hoelzlem/SchBat/README.md

# SchBat
Schaltungsentwicklung für Batteriesysteme Praktikum
