hoelzlem/SchBat/Poster/Ladezustandsbestimmung.pptx

## Ladezustandsbestimmung

Technische Universität München
Fakultät für Elektrotechnik
Lehrstuhl für Elektrische Energiespeichertechnik
Simon Diehl
Markus Hölzle
März 2018

- mit Ruhespannungskennline und Ladungsmessung

- Implementierung von Hard- und Software

- Ziel: Bestimmung der aktuell im Akku enthaltenen Ladung und der verbleibenden Laufzeit des Systems beziehungsweise der Restladezeit
- Motivation: Mit dieser Information, kann der Nutzer besser bewerten, ob die aktuelle Betriebsdauer der Leuchte für den angedachten Einsatz noch ausreicht. Unvorhergesehener Ausfall ist, ein Defekt ausgenommen, kaum noch möglich.

Ziel

1. Bestimmung des initialen Ladezustands beim Start des Geräts mittels der Klemmenspannung aus der vorher bekannten Ruhespannungskennlinie
2. Messung der geflossenen Ladung (Laden oder Entladen), um den Ladezustand während des Betriebs zu beobachten. Bedingt durch den Stromfluss im Betrieb und die damit einhergehenden Überspannungen im Akku ist eine Bestimmung mittels Ruhespannungskennlinie hier nicht mehr möglich.

Prinzip

Spannungsmessung

- Bestimmung des initialen Ladezustand aus Messung der Klemmenspannung der verbundenen Zelle
- Nach ausreichend langer Ruhezeit kann angenommen werden, dass die Klemmenspannung der Gleichgewichtsspannung der Zelle entspricht und die Abbildung f:U_K →SOC somit gültig ist
- Differenzielle Messung über unbelastete Anschlüsse → Laststrombedingte Spannungsfälle werden vermieden
- Abschaltung der Messelektronik für geringen Ruhestrom → Schutz vor Tiefentladung
- Die unjustierte Genauigkeit beträgt etwa 10 mV und führt damit zu einem maximalen Fehler von circa 5 % SOC

Signalverarbeitung

Strommessung

- Für die Aktualisierung des Ladezustands im Betrieb wird die geflossene Ladung herangezogen. Diese kann durch Integration des Laststroms über die Zeit berechnet werden.
- Ermittlung des Klemmenstroms mittels Messwiderstand → hohe Genauigkeit und Bandbreite bei niedrigen Kosten
- Messung auf Seite der positiven Versorgungsspannung → Beeinflussung des Bezugspotenzials wird verhindert
- Zeitdiskrete Integration benötigt eine genaue Zeitbasis → Minimierung von Driftfehlern → Generierung mit Quarzoszillator mit einer Genauigkeit von 30 ppm
- Die unjustierte Genauigkeit beträgt im Versuch etwa 10 mA und führt damit zu einem Fehler von 10mA⋅t/C_N was im gegebenen Fall circa 0.5% SOC pro Betriebsstunde entspricht

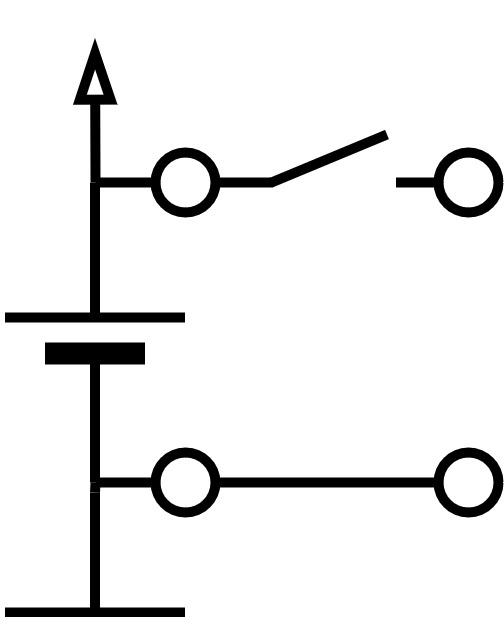
[picture p4: figure]
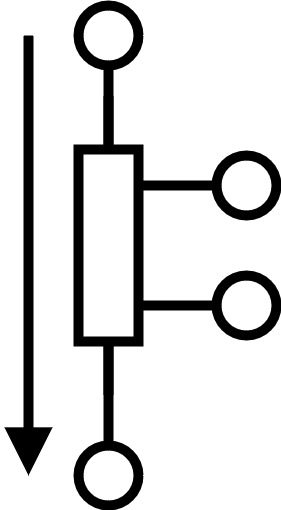
[picture p5: figure]

Die Sensorik für Spannungs- und Strommessung benötigt analoge sowie digitale Signalverarbeitung, um nutzbare Messdaten liefern zu können. Die Messkette ist dabei für beide gleich.

Differenzverstärker
- Messsignal auf FSR des ADC anpassen
- Gleichtaktsignal unterdrücken, um Informationsgehalt zu maximieren
- Hohe Bandbreite: f_g ≥10 kHz

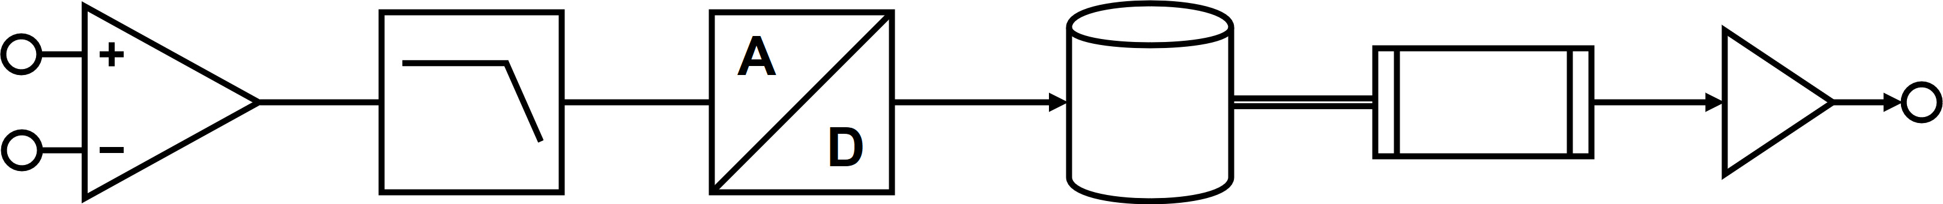
[picture p6: figure]

Tiefpassfilter
- Anti-Alias Filter
- Butterworth-Tiefpass: a(1 kHz)=3 dB a(16 kHz)=40 dB

AD-Wandler
- FSR=2.5 V
- ENOB=9 bit
- f_s >32 kHz

Ringpuffer
- Speichert 16 Samples pro Kanal

Oversampling
- Mittelwertbildung mit 16 Samples (SINC-Filter) → ENOB=11 bit

Skalierung
- Skalierung des ADC-Codes mit Offset und Gain
- Messwert in SI-Einheiten in Dezimal-Fixpunkt-darstellung

Ladezustandsbestimmung

- Berechnung des Ladezustands nach dem Prinzip des Coulomb Counting
- Bei der Initialisierung des Ladezustands wird eine Look-Up-Tabelle der Ruhespannungskennlinie mit linearer Interpolation zwischen den Stützpunkten verwendet. Der Ladezustand kann unter guten Bedingungen (Ruhespannungsverlauf der Zelle entspricht dem hinterlegten Profil) auf ein Promille genau aufgelöst werden (Fehler der Spannungsmessung nicht berücksichtigt).
- Die verbleibende Lade- bzw. Entladezeit wird mit linearer Extrapolation eines Stromtrends (stark tiefpassgefilterter Strom mit T_g =100 s→f_g ≅1.6 mHz ) in Bezug auf die aktuell enthaltene Ladung geschätzt.
Ausblick:
- In langen Phasen mit geringer Stromaufnahme, zusätzlich Ruhespannungskennlinie zur Korrektur des Ladungsintegrators nutzen (z. B. in der CV-Ladephase oder im Betrieb mit geringem Laststrom)
- Verschleiß der Zelle berücksichtigen, indem die Restkapazität anstelle der Nennkapazität für die Berechnung des SOC genutzt wird

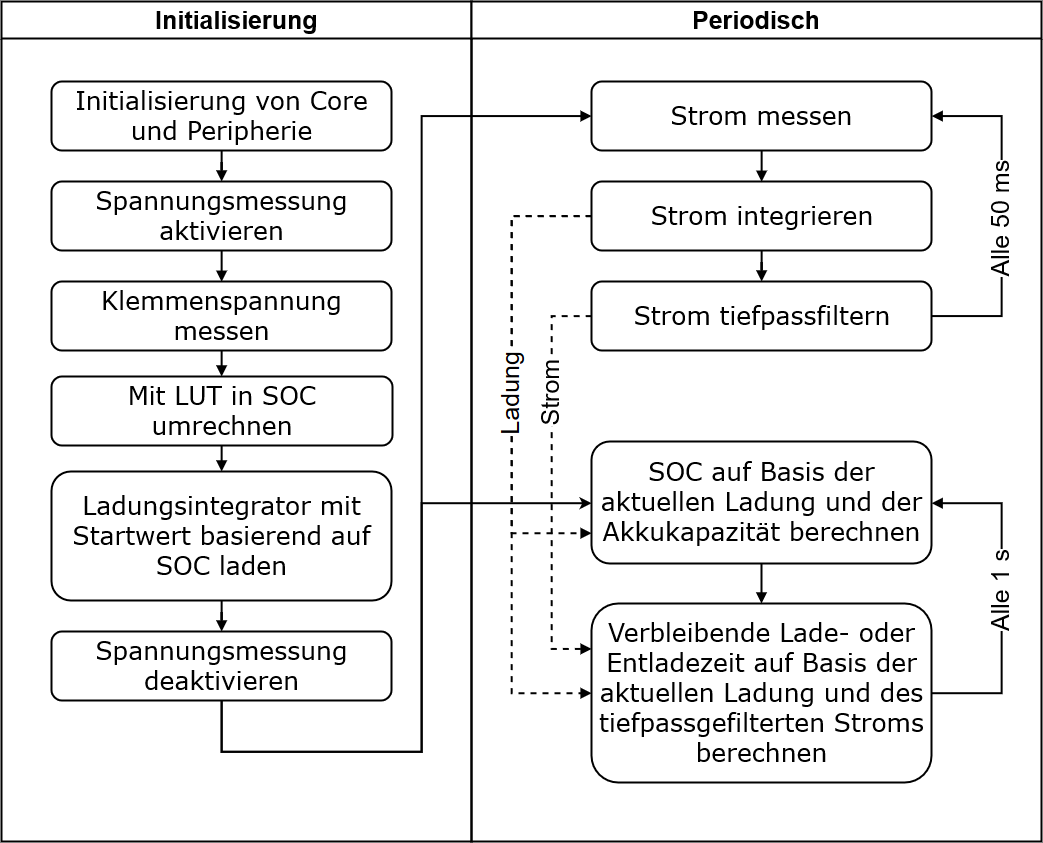
[picture p7: figure]
