hoelzlem/SchBat/PCB/DevBoard/DevBrd.brd

## EAGLE design PCB/DevBoard/DevBrd.brd (2018-04-06)

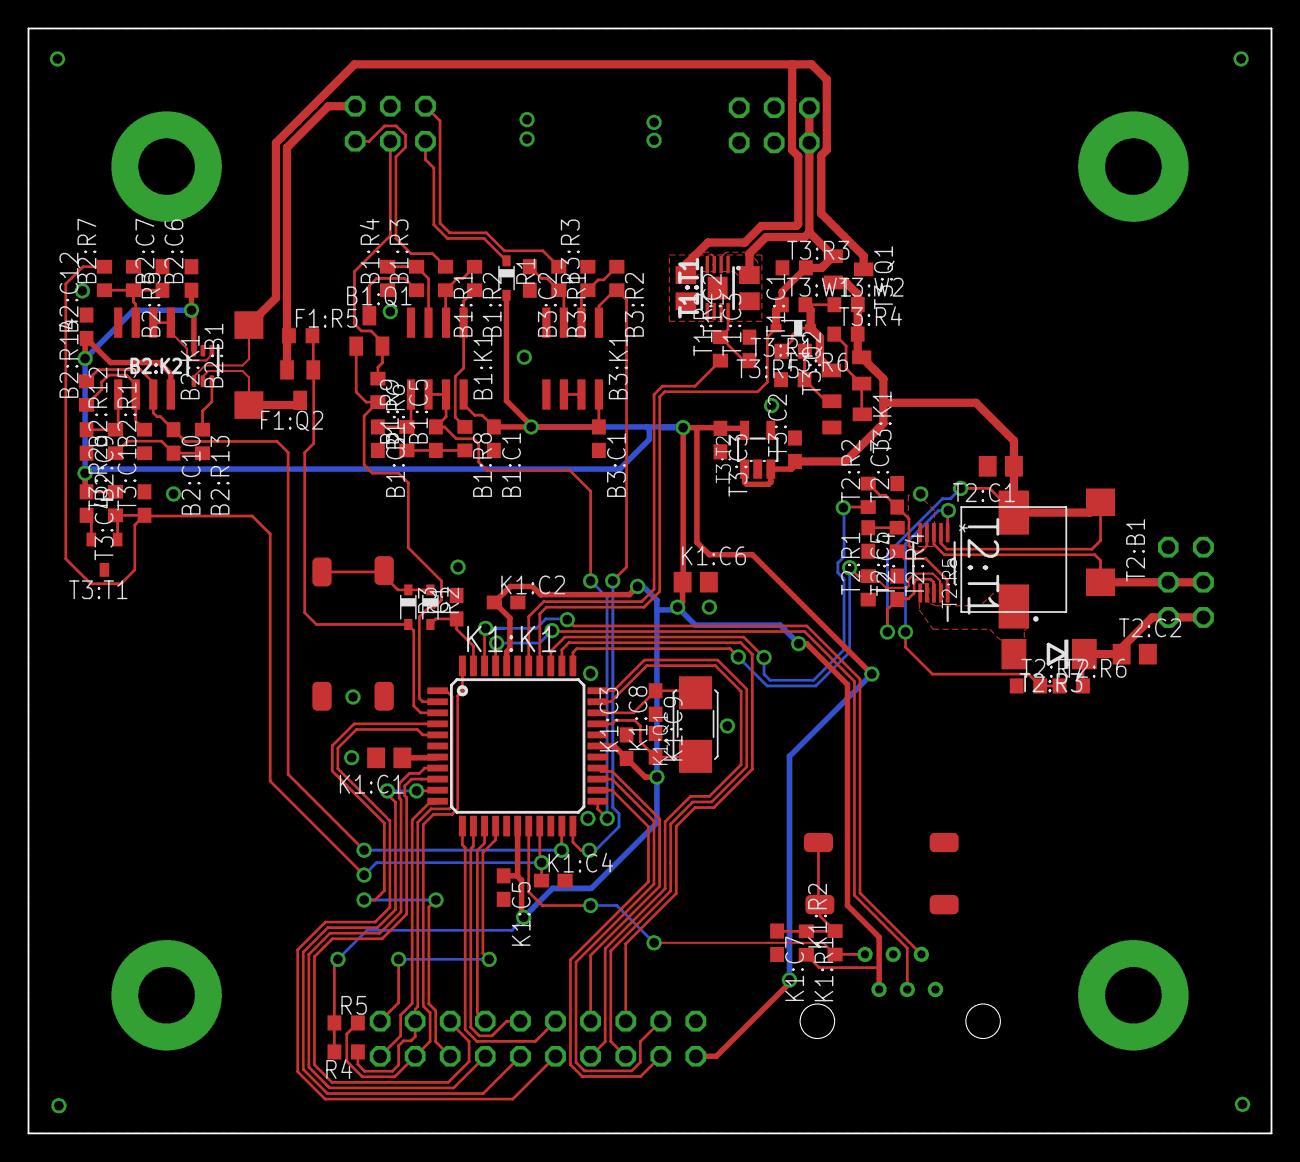
[picture p8: board DevBrd.brd from above]

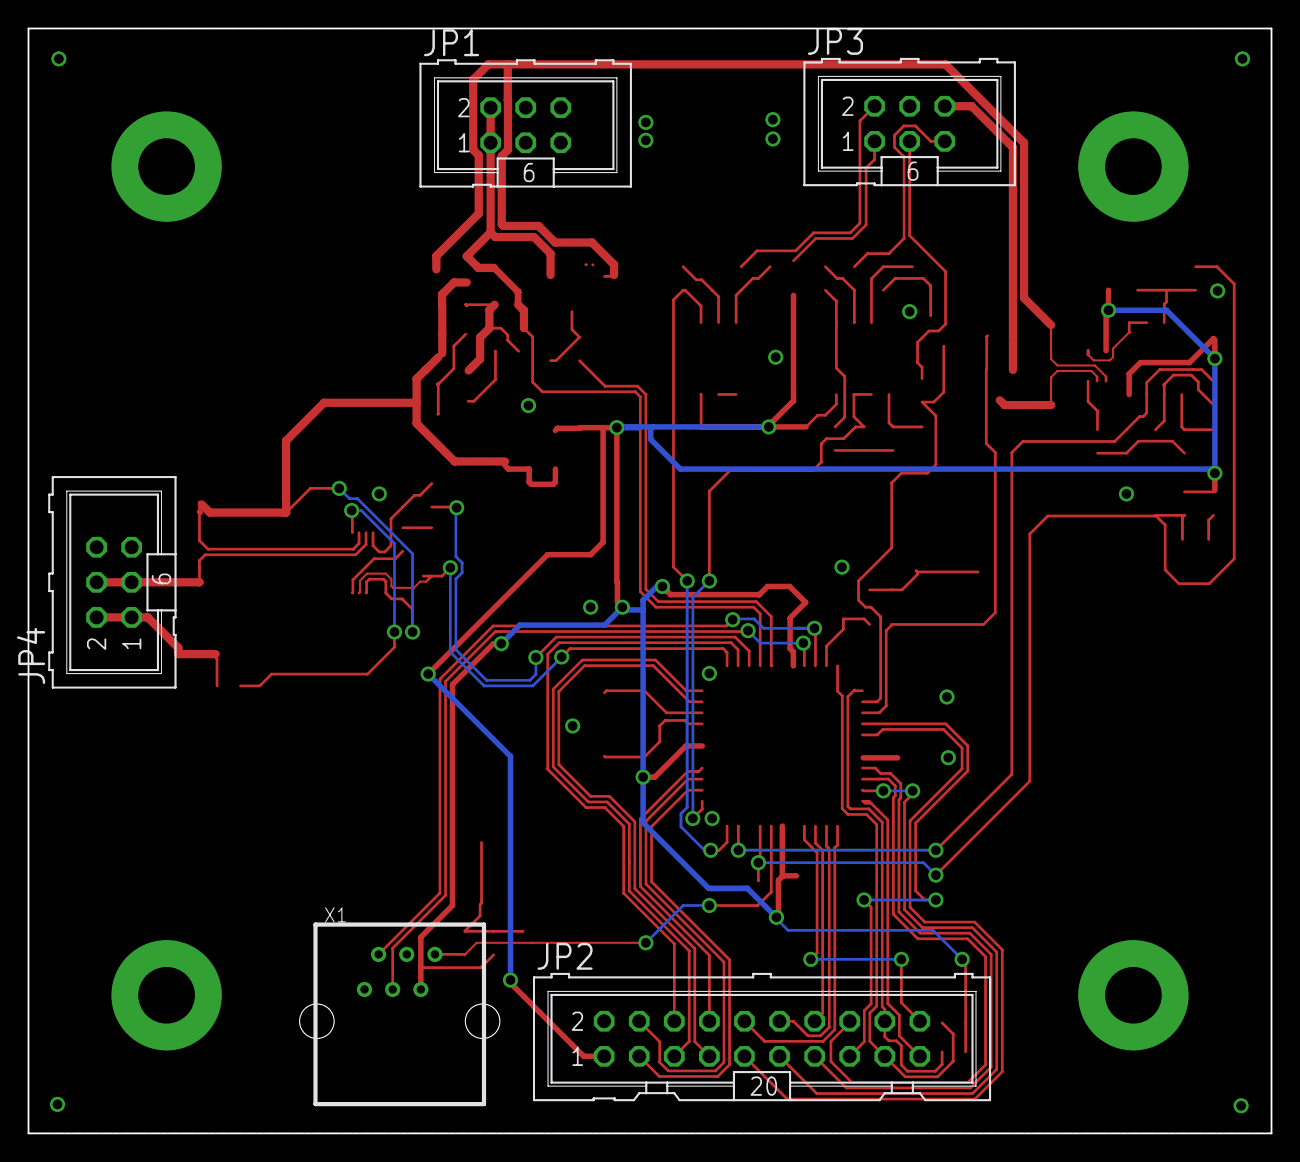
[picture p9: board DevBrd.brd from below]

Board: 2 copper layers, 90.0 x 80.0 mm, 96 parts (5 on the bottom side), 73 nets.

Parts:
B1:C1, B2:C6, B2:C12, B3:C1: 100 n / 6.3 V; C0603
B1:C2, B2:C9: 1.5 n / 6.3 V; C0603
B1:C5, B2:C10: 15 n / 6.3 V; C0603
B1:K1, B2:K1, B3:K1: MCP662; SO-8
B1:Q1: RZR040P01TL; SOT-23-3
B1:R1, B1:R3: 17.4 k; R0603
B1:R2, B1:R4, B1:R6: 10 k; R0603
B1:R8: 7.5 k; R0603
B1:R9: 133 k; R0603
B2:B1: 5 m; R2512W
B2:C7: 1 µ / 6.3 V; C0603
B2:K2: INA210; SC70-6
B2:R5: 2.94 k; R0603
B2:R7: 9.31 k; R0603
B2:R12: 143 k; R0603
B2:R13: 6.81 k; R0603
B2:R14: 3.92 k; R0603
B2:R15: 28 k; R0603
B3:C2: 150 n / 6.3 V; C0603
B3:R1: 100 k; R0603
B3:R2: 56.2 k; R0603
B3:R3: 44.2 k; R0603
C1: 100 n / 6.3 V; C0603
F1:Q2: RZR040P01TL; SOT-23-3
F1:R5: 10 k; R0603
JP1, JP3, JP4: 2.54 mm male; ML6
JP2: 2.54 mm male; ML20
K1:C1: 10 µ / 6.3 V; C0805
K1:C2, K1:C3, K1:C4, K1:C5, K1:C7: 100 n / 6.3 V; C0603
K1:C6: 4.7 µ / 6.3 V; C0805
K1:C8, K1:C9: 18 p / 6.3 V; C0603
K1:K1: PIC32MX150F128D; TQFP-44
K1:Q1: ABM3
K1:R1: 10 k; R0603
K1:R2: 1 k; R0603
K1:S1: JTP1138X6
R1, R2, R3: BAT60; SOD323
R4, R5: 4.7 k; R0603
S1: JTP1138X6
T1:C1, T1:C2, T2:C1: 4.7 µ / 10 V; C0805
T1:C3, T2:C3, T3:C1, T3:C3, T3:C4: 1 µ / 6.3 V; C0603
T1:R2, T3:R4: 2 k; R0603
T1:T1: MCP73831DFN; MCP73831_DFN
T2:B1: 50 m; R2512W
T2:C2: 4.7 µ / 25 V; C0805
T2:C4, T2:C5: 10 n / 6.3 V; C0603
T2:R1, T3:R3: 10 k; R0603
T2:R2: 1 k; R0603
T2:R3: STPS1L30U; DO214AA
T2:R4, T3:W1, T3:W2: 0; R0603
T2:R5: MCSDRH73B
T2:R6: 102 k; R0603
T2:R7: 14.7 k; R0603
T2:T1: LT1618EMSPBF; SOP50P490X110-10N
T3:C2: 1 µ / 10 V; C0603
T3:K1: IRLML6344TRPBF; SOT-23-3
T3:Q1, T3:Q2: RZR040P01TL; SOT-23-3
T3:R1: BAT60; SOD323
T3:R2: 300; R0603
T3:R5: 3.64 k; R0603
T3:R6: 1.3 k; R0603
T3:T1: LM4040A25IDBZT; DBZ_R-PDSO-G3
T3:T2: XC6210B332MR; SOT-23-5L
X1: RJ11WüRTH; XRJK-S-01-6-6-0-2G2-NO

Connections:
!BAT_CONNECT: F1:Q2.1, F1:R5.2, K1:K1.3, R3.A
!CH_CTRL: K1:K1.38, T1:R2.1
!LED_SHDN: K1:K1.34, T2:R1.2, T2:T1.9
!MCLR: K1:K1.18, K1:R2.1, X1.6
!U_SENS_EN: B1:Q1.1, B1:R6.2, K1:K1.2
+2V5: B2:R7.2, K1:C4.1, K1:K1.19, T3:C1.1, T3:R2.1, T3:T1.1
+2V8..3V3: B1:C1.1, B1:K1.8, B2:C6.1, B2:C12.1, B2:K1.8, B2:K2.3, B3:C1.1, B3:K1.8, JP2.1, K1:C2.1, K1:C3.1, K1:C5.1, K1:C6.1, K1:K1.17, K1:K1.28, K1:K1.40, K1:R1.2, R1.A, R4.2, R5.1, T3:C3.1, T3:C4.1, T3:R2.2, T3:T2.5, X1.5
+5V: JP1.1, JP1.2, K1:K1.37, T1:C1.1, T1:T1.1, T1:T1.2, T3:Q1.1, T3:R1.A, T3:R3.2, T3:W1.1
ADC1: JP2.3, K1:K1.24
ADC2: JP2.4, K1:K1.25
B1:N$1: B1:Q1.3, B1:R3.1
B1:N$2: B1:K1.3, B1:R3.2, B1:R4.2
B1:N$3: B1:K1.1, B1:R2.2, B1:R8.1
B1:N$5: B1:K1.2, B1:R1.2, B1:R2.1
B1:N$6: B1:C5.1, B1:R8.2, B1:R9.1
B1:N$9: B1:C2.1, B1:K1.5, B1:R9.2
B2:+0V6: B2:K1.1, B2:K1.2, B2:K2.1
B2:N$1: B2:C7.1, B2:K1.3, B2:R5.2, B2:R7.1
B2:N$4: B2:K2.6, B2:R13.1
B2:N$12: B2:C9.1, B2:K1.5, B2:R12.2
B2:N$13: B2:C10.2, B2:R12.1, B2:R13.2
B2:N$14: B2:K1.6, B2:R14.1, B2:R15.2
B3:N$1: B3:K1.6, B3:K1.7
B3:N$2: B3:C2.1, B3:K1.3, B3:R1.2
B3:N$4: B3:K1.2, B3:R2.1, B3:R3.1
GND: B1:C1.2, B1:C2.2, B1:K1.4, B1:R4.1, B2:C6.2, B2:C7.2, B2:C9.2, B2:C12.2, B2:K1.4, B2:K2.2, B2:R5.1, B2:R15.1, B3:C1.2, B3:C2.2, B3:K1.4, B3:K1.5, B3:R3.2, C1.2, JP1.3, JP1.4, JP2.2, JP3.4, K1:C1.2, K1:C2.2, K1:C3.2, K1:C4.2, K1:C5.2, K1:C6.2, K1:C7.2, K1:C8.2, K1:C9.2, K1:K1.6, K1:K1.16, K1:K1.20, K1:K1.29, K1:K1.39, K1:S1.1, K1:S1.2, S1.1, S1.2, T1:C1.2, T1:C2.2, T1:C3.2, T1:T1.6, T1:T1.9, T2:C1.2, T2:C2.2, T2:C3.2, T2:C4.2, T2:C5.2, T2:R1.1, T2:R7.1, T2:T1.5, T3:C1.2, T3:C2.2, T3:C3.2, T3:C4.2, T3:K1.2, T3:R3.1, T3:R6.1, T3:T1.2, T3:T2.2, X1.4
GPIO1: JP2.5, K1:K1.33
GPIO2: JP2.6, K1:K1.35
GPIO3: JP2.7, K1:K1.32
GPIO4: JP2.8, K1:K1.26
GPIO5: JP2.9, K1:K1.5
GPIO6: JP2.10, K1:K1.12
GPIO7: JP2.11, K1:K1.10
GPIO8: JP2.12, K1:K1.13
GPIO9: JP2.13, K1:K1.8
I_BAT_FORCE+: F1:Q2.2, F1:R5.1, JP3.6
K1:N$2: K1:C1.1, K1:K1.7
K1:N$10: K1:C7.1, K1:R1.1, K1:R2.2, K1:S1.3, K1:S1.4
K1:RA2_OSC1: K1:C8.1, K1:K1.30, K1:Q1.P$1
K1:RA3_OSC2: K1:C9.1, K1:K1.31, K1:Q1.P$2
LED_IADJ: K1:K1.36, T2:R2.1
unnamed: B2:B1.1, B2:K2.5, F1:Q2.3
unnamed: B2:B1.2, B2:K2.4, T1:C2.1, T1:T1.3, T1:T1.4, T3:Q1.3
unnamed: C1.1, K1:K1.43, R2.A
unnamed: R2.C, R3.C, S1.3, S1.4
PGC: K1:K1.42, X1.2
PGD: K1:K1.41, X1.3
SCK1: JP2.14, K1:K1.14
SCL1: JP2.17, K1:K1.44, R5.2
SDA1: JP2.18, K1:K1.1, R4.1
SDI1: JP2.16, K1:K1.9
SDO1: JP2.15, K1:K1.4
T1:N$2: T1:C3.1, T1:R2.2, T1:T1.8
T2:N$1: T2:C3.1, T2:R2.2, T2:T1.4
T2:N$2: T2:R4.2, T2:T1.10
T2:N$3: T2:C4.1, T2:R4.1
T2:N$6: T2:R6.1, T2:R7.2, T2:T1.1
T2:SW: T2:R3.A, T2:R5.P$1, T2:T1.6, T2:T1.7
T3:N$1: T3:Q2.3, T3:R1.C, T3:R5.2, T3:W1.2, T3:W2.1
T3:N$2: T3:K1.3, T3:Q2.1, T3:R4.1
T3:N$3: T3:K1.1, T3:R5.1, T3:R6.2
U1RX: JP2.19, K1:K1.11
U1TX: JP2.20, K1:K1.15
U_I_MEAS: B2:C10.1, B2:K1.7, B2:R14.2, K1:K1.21
U_T_MEAS: B3:K1.1, B3:R2.2, K1:K1.22
U_U_MEAS: B1:C5.2, B1:K1.6, B1:K1.7, K1:K1.23
V+: T2:B1.1, T2:C1.1, T2:C5.1, T2:R5.P$2, T2:T1.2, T2:T1.8, T3:C2.1, T3:Q1.2, T3:Q2.2, T3:R4.2, T3:T2.1, T3:T2.3, T3:W2.2
VDD_SENSOR: JP3.1, R1.C
V_BAT_SENSE+: B1:Q1.2, B1:R6.1, JP3.3
V_BAT_SENSE-: B1:R1.1, JP3.5
V_LED+: JP4.1, JP4.2, T2:C2.1, T2:R3.C, T2:R6.2
V_LED-: JP4.3, JP4.4, T2:B1.2, T2:T1.3
V_SENSOR: B3:R1.1, JP3.2
