hoelzlem/SchBat/(commit log)

2018-03-18 Initial commit - containing pin config and autogenerated files
2018-03-18 * Added procedure for converting ADC measurement to voltage * Added main.h for global definitions
2018-03-18 * Added BMS module with function for calculation of battery voltage, current and temperature
2018-03-18 Added skeleton for BMS state machine
2018-03-26 Rewrote from scratch - AD now working (Vref- as lower reference not working)
    [BMS.c, BMS.h, main.c]
2018-03-28 Added mayor features of BMS
2018-04-06 Added PCB design files
    [DevBrd.brd, DevBrd.sch]
2018-04-06 * Added design files for closing presentation poster * Moved miscellaneous files to a separate folder
    [OCV.csv]
